bao-eng/glass2glass-hw/cam_delay_meas_photo.kicad_pcb

## KiCad design cam_delay_meas_photo.kicad_pcb (2023-09-23)

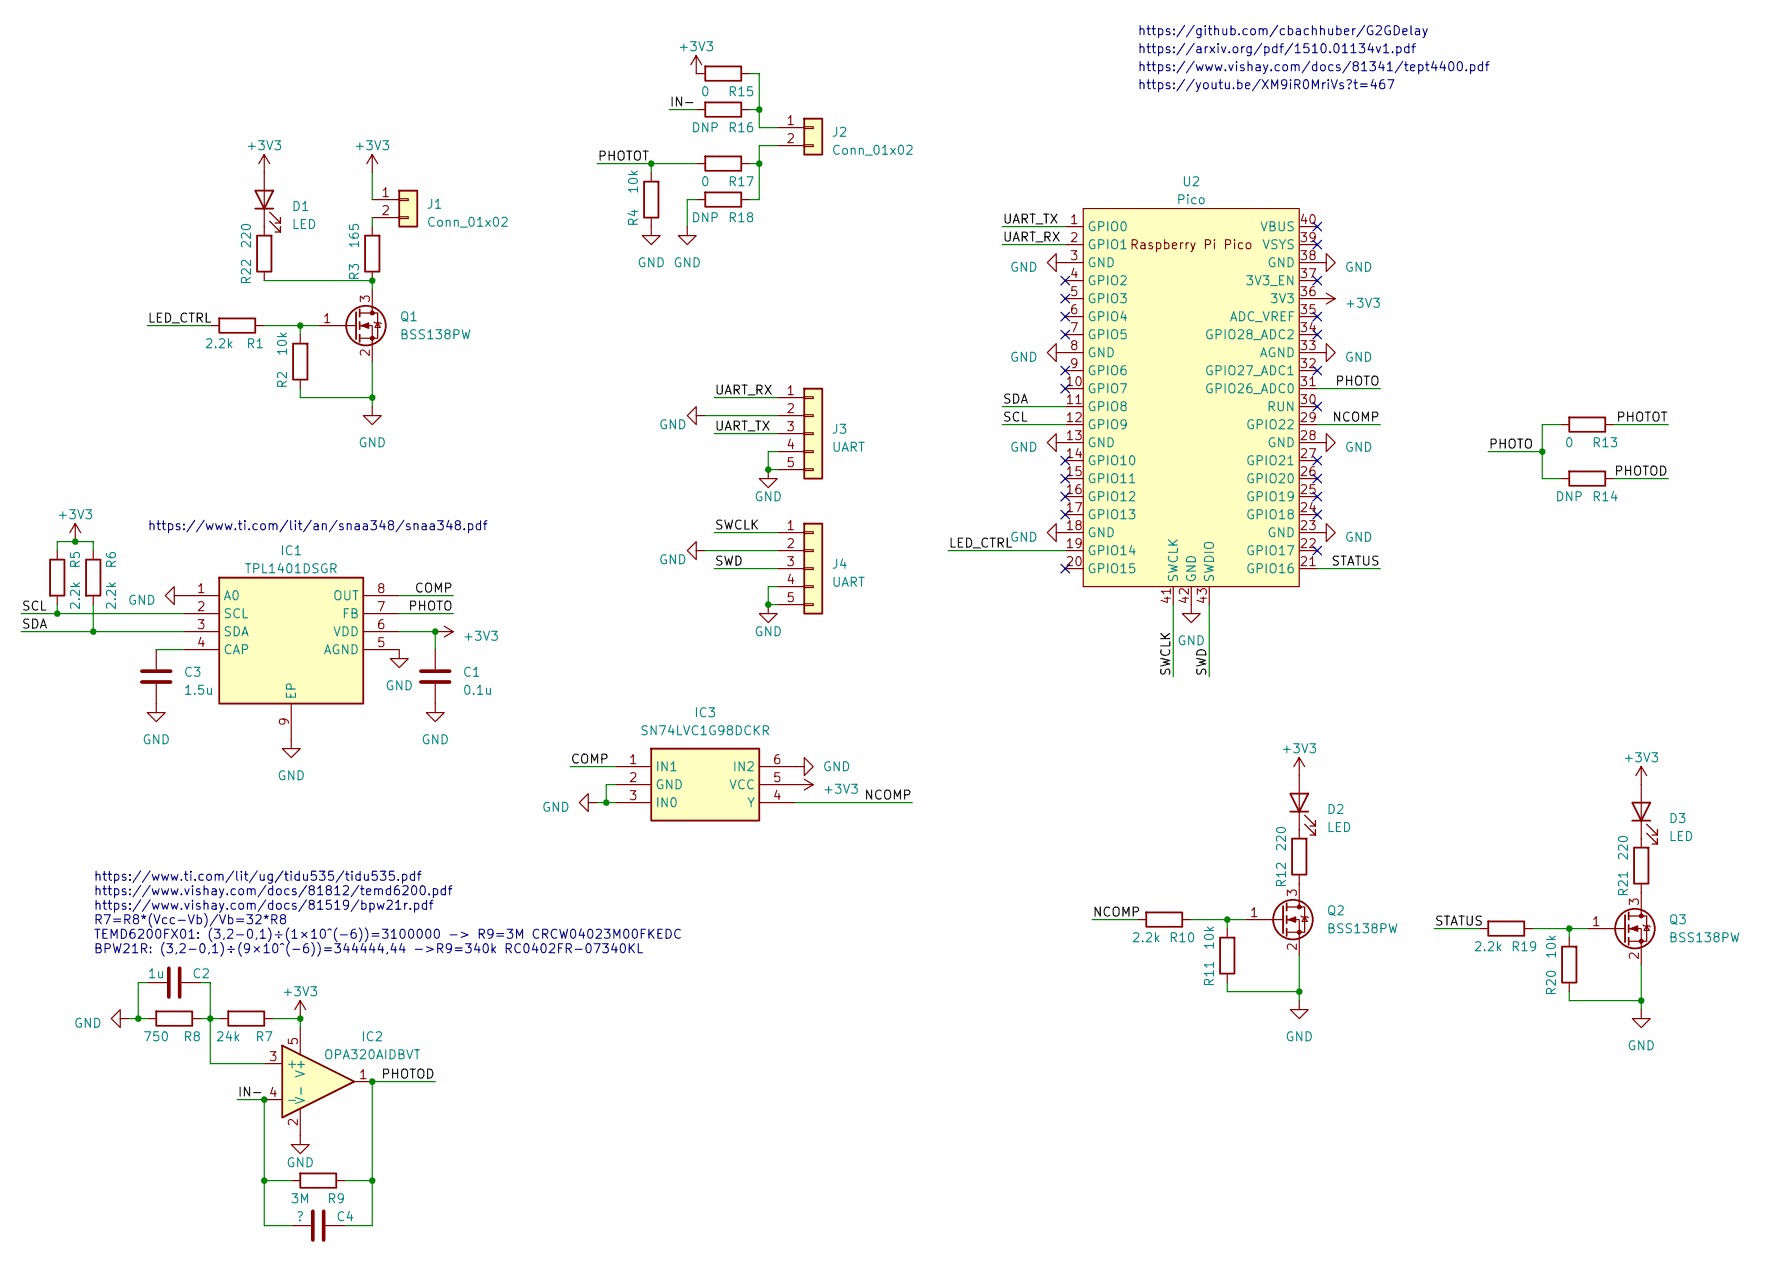
[picture p1: schematic cam_delay_meas_photo.kicad_sch]

Parts:
C1: 0.1u; C_0805_2012Metric; MPN CC0805KRX7R9BB104
C2: 1u; C_0402_1005Metric; MPN CC0402KRX5R5BB105
C3: 1.5u; C_0805_2012Metric; MPN CC0805ZRY5V7BB155
C4: ?; C_0402_1005Metric
D1: LED; LED_0603_1608Metric; MPN LTST-C191KGKT
D2: LED; LED_0603_1608Metric; MPN LTST-C191KFKT
D3: LED; LED_0603_1608Metric; MPN LTST-C191TBKT
IC1: TPL1401DSGR; SON50P200X200X80-9N; Mouser Part Number 595-TPL1401DSGR
IC2: OPA320AIDBVT; SOT95P280X145-5N; Mouser Part Number 595-OPA320AIDBVT
IC3: SN74LVC1G98DCKR; SOT65P210X110-6N; Mouser Part Number 595-SN74LVC1G98DCKR
J1, J2: Conn_01x02; SHDRRA2W80P0X350_1X2_840X920X720P
J3, J4: UART; CONN_SM03B-SRSS-TB_JST; MPN SM03B-SRSS-TB(LF)(SN)
Q1, Q2, Q3: BSS138PW; SOT65P210X110-3N
R1, R6, R10, R19: 2.2k; R_0402_1005Metric
R2, R11, R20: 10k; R_0402_1005Metric; MPN RC0402FR-0710KL
R3: 165; R_0805_2012Metric; MPN RC0805FR-07165RL
R4: 10k; R_0805_2012Metric; MPN RC0805FR-0710KL
R5: 2.2k; R_0402_1005Metric; MPN RC0402FR-072K2L
R7: 24k; R_0402_1005Metric; MPN RC0402FR-0724KL
R8: 750; R_0402_1005Metric; MPN RC0402FR-07750RL
R9: 3M; R_0402_1005Metric; MPN CRCW04023M00FKEDC
R12, R21, R22: 220; R_0402_1005Metric; MPN RC0402FR-07220RL
R13, R15, R17: 0; R_0402_1005Metric; MPN RC0402JR-070RL
R14, R16, R18: DNP; R_0402_1005Metric
U2: Pico; RPi_Pico_SMD

Connections:
+3V3: C1.1, D1.2 (A), D2.2 (A), D3.2 (A), IC1.6 (VDD), IC2.5 (V+), IC3.5 (VCC), J1.1, R5.1, R6.1, R7.1, R15.2, U2.36 (3V3)
/COMP: IC1.8 (OUT), IC3.1 (IN1)
/IN-: C4.1, IC2.4 (-), R9.2, R16.2
/LED_CTRL: R1.2, U2.19 (GPIO14)
/NCOMP: IC3.4 (Y), R10.2, U2.29 (GPIO22)
/PHOTO: IC1.7 (FB), R13.2, R14.2, U2.31 (GPIO26_ADC0)
/PHOTOD: C4.2, IC2.1, R9.1, R14.1
/PHOTOT: R4.2, R13.1, R17.2
/SCL: IC1.2 (SCL), R5.2, U2.12 (GPIO9)
/SDA: IC1.3 (SDA), R6.2, U2.11 (GPIO8)
/STATUS: R19.2, U2.21 (GPIO16)
/SWCLK: J4.1, U2.41 (SWCLK)
/SWD: J4.3, U2.43 (SWDIO)
/UART_RX: J3.1, U2.2 (GPIO1)
/UART_TX: J3.3, U2.1 (GPIO0)
GND: C1.2, C2.1, C3.2, IC1.1 (A0), IC1.5 (AGND), IC1.9 (EP), IC2.2 (V-), IC3.2 (GND), IC3.3 (IN0), IC3.6 (IN2), J3.2, J3.4, J3.5, J4.2, J4.4, J4.5, Q1.2 (S), Q2.2 (S), Q3.2 (S), R2.1, R4.1, R8.2, R11.1, R18.2, R20.1, U2.3 (GND), U2.8 (GND), U2.13 (GND), U2.18 (GND), U2.23 (GND), U2.28 (GND), U2.33 (AGND), U2.38 (GND), U2.42 (GND)
unnamed: D1.1 (K), R22.2
unnamed: D2.1 (K), R12.2
unnamed: D3.1 (K), R21.2
unnamed: C3.1, IC1.4 (CAP)
unnamed: C2.2, IC2.3 (+), R7.2, R8.1
unnamed: J1.2, R3.2
unnamed: J2.1, R15.1, R16.1
unnamed: J2.2, R17.1, R18.1
unnamed: Q1.3 (D), R3.1, R22.1
unnamed: Q1.1 (G), R1.1, R2.2
unnamed: Q2.3 (D), R12.1
unnamed: Q2.1 (G), R10.1, R11.2
unnamed: Q3.3 (D), R21.1
unnamed: Q3.1 (G), R19.1, R20.2

Notes on the sheet:
https://www.ti.com/lit/an/snaa348/snaa348.pdf
https://www.vishay.com/docs/81341/tept4400.pdf
https://youtu.be/XM9iR0MriVs?t=467
https://www.ti.com/lit/ug/tidu535/tidu535.pdf https://www.vishay.com/docs/81812/temd6200.pdf https://www.vishay.com/docs/81519/bpw21r.pdf R7=R8*(Vcc-Vb)/Vb=32*R8 TEMD6200FX01: (3,2−0,1)÷(1×10^(−6))=3100000 -> R9=3M CRCW04023M00FKEDC BPW21R: (3,2−0,1)÷(9×10^(−6))=344444,44 ->R9=340k RC0402FR-07340KL
https://github.com/cbachhuber/G2GDelay
https://arxiv.org/pdf/1510.01134v1.pdf

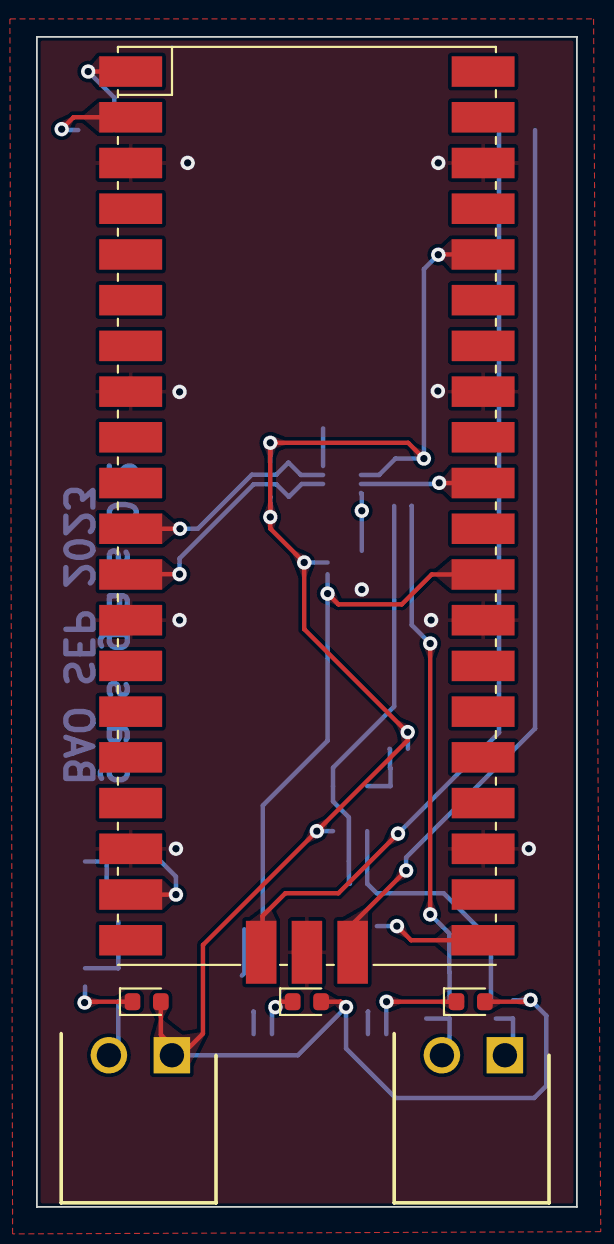
[picture p2: board cam_delay_meas_photo.kicad_pcb from above]

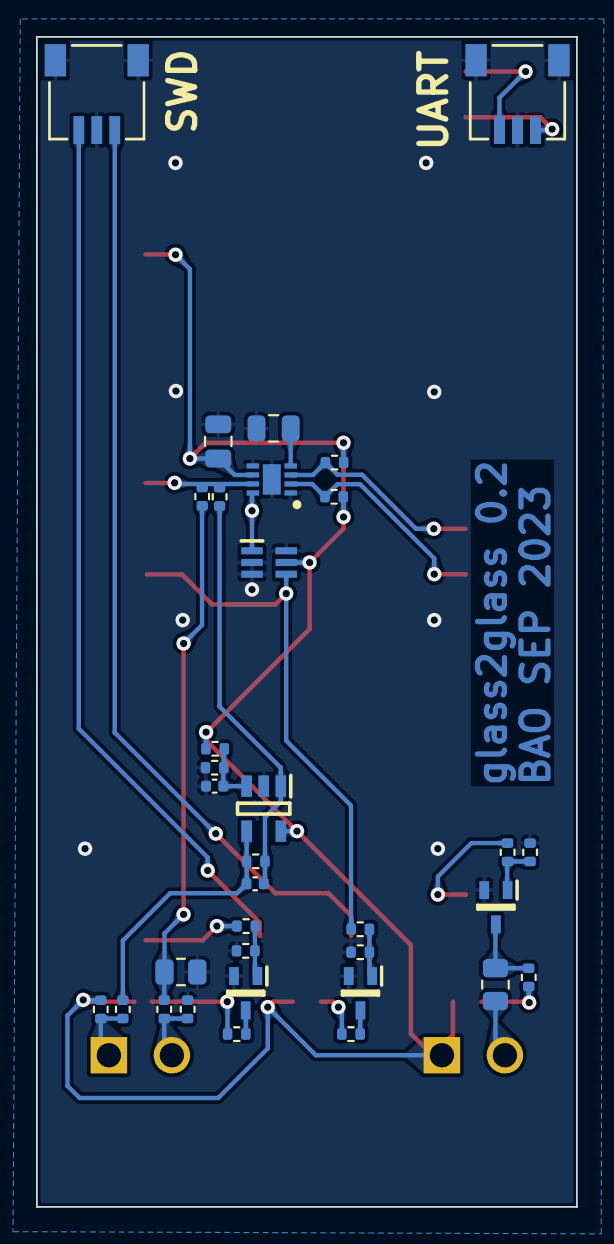
[picture p3: board cam_delay_meas_photo.kicad_pcb from below]

Board: 2 copper layers, 30.0 x 65.0 mm, 40 parts (34 on the bottom side), 30 nets.
