bao-eng/glass2glass-hw/(commit log)

2023-09-23 FETs fixed + added inverter
    [cam_delay_meas_photo.kicad_sch]
2023-09-23 glass2glasss pcb v0.2
    [cam_delay_meas_photo-B_Cu.gbr, cam_delay_meas_photo-B_Mask.gbr, cam_delay_meas_photo-B_Silkscreen.gbr, cam_delay_meas_photo-Edge_Cuts.gbr, cam_delay_meas_photo-F_Cu.gbr, cam_delay_meas_photo-F_Mask.gbr, cam_delay_meas_photo-F_Silkscreen.gbr, cam_delay_meas_photo-PTH.drl]
